frankich99/robotica_brazo_robotica/img/detalle_servo_ysd035_35kg.jpeg

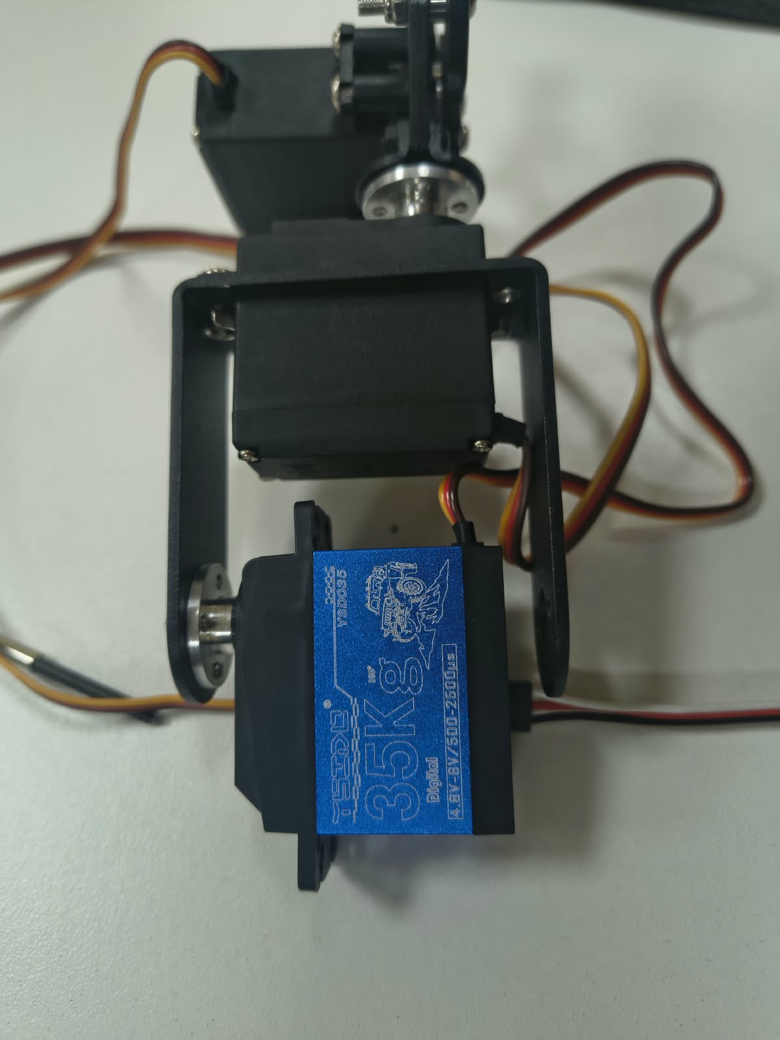
img/detalle_servo_ysd035_35kg.jpeg
