frankich99/robotica_brazo_robotica/img/esp32_cam_programador_mb.jpeg

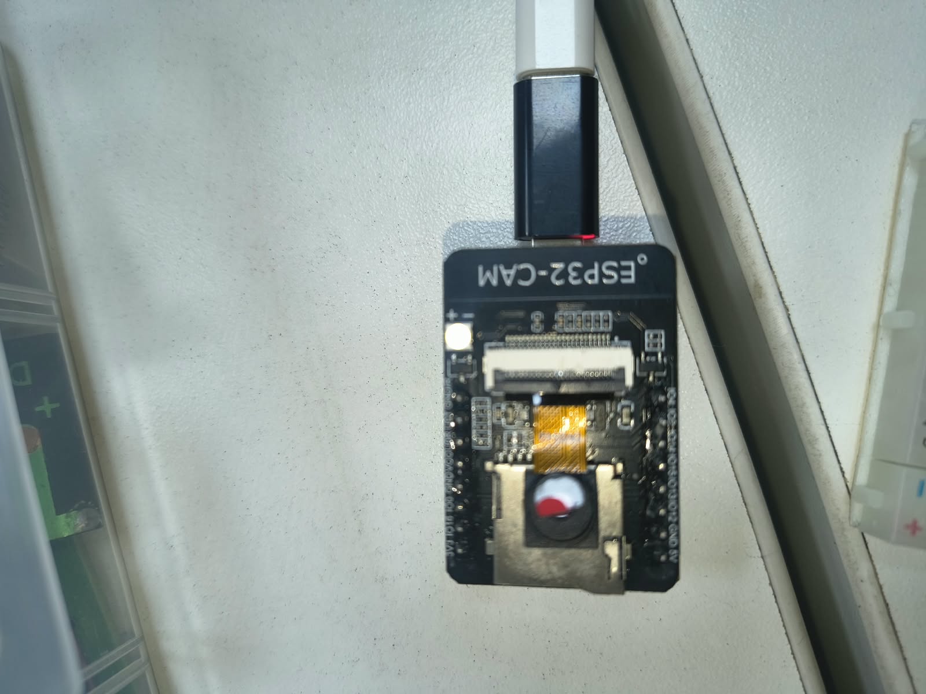
img/esp32_cam_programador_mb.jpeg
