frankich99/robotica_brazo_robotica/img/WhatsApp Image 2026-10-29 at 7.38.52 AM (4).jpeg

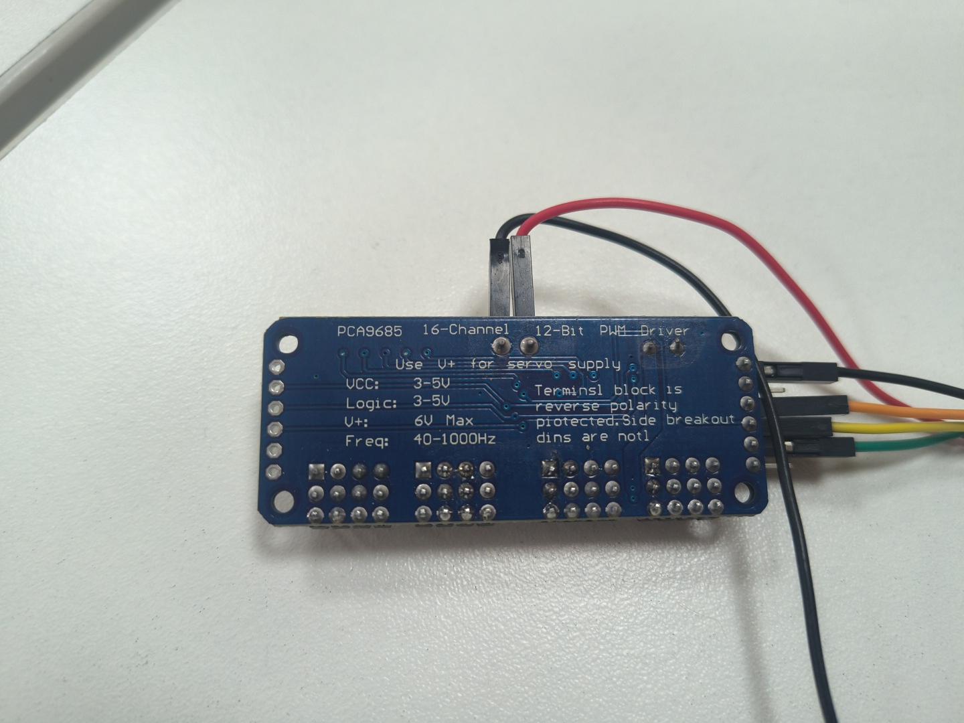
img/WhatsApp Image 2026-10-29 at 7.38.52 AM (4).jpeg
