frankich99/robotica_brazo_robotica/img/WhatsApp Image 2026-10-29 at 9.01.49 AM (1).jpeg

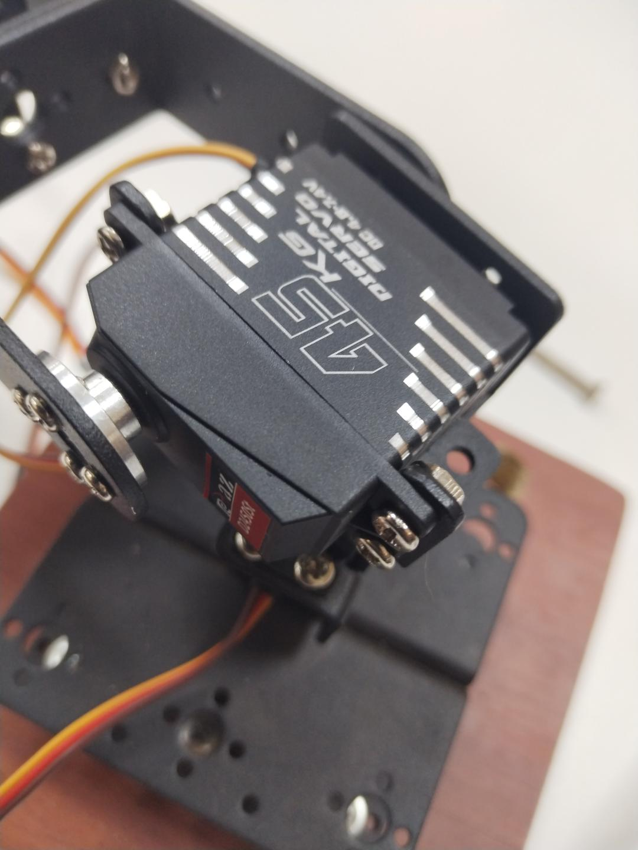
img/WhatsApp Image 2026-10-29 at 9.01.49 AM (1).jpeg
