frankich99/robotica_brazo_robotica/codigo/camara_esp32_ap_stream/camara_esp32_ap_stream.ino

#include <Arduino.h>
#include "esp_camera.h"
#include <WiFi.h>

// ===========================
// Select camera model in board_config.h
// ===========================
#include "board_config.h"

// ===========================
// MODO AP: la CAM crea su propia red
// ===========================
const char *ssid     = "FRANKI-HE";
const char *password = "123456789";   // minimo 8 caracteres

// Si prefieres modo STA (router), descomenta esta linea:
// #define USE_STA
const char *sta_ssid = "ROBOTICA_ROUTER";
const char *sta_pass = "123456789";

void startCameraServer();
void setupLedFlash();

void setup() {
  Serial.begin(115200);
  Serial.setDebugOutput(true);
  Serial.println();

  camera_config_t config;
  config.ledc_channel = LEDC_CHANNEL_0;
  config.ledc_timer = LEDC_TIMER_0;
  config.pin_d0 = Y2_GPIO_NUM;
  config.pin_d1 = Y3_GPIO_NUM;
  config.pin_d2 = Y4_GPIO_NUM;
  config.pin_d3 = Y5_GPIO_NUM;
  config.pin_d4 = Y6_GPIO_NUM;
  config.pin_d5 = Y7_GPIO_NUM;
  config.pin_d6 = Y8_GPIO_NUM;
  config.pin_d7 = Y9_GPIO_NUM;
  config.pin_xclk = XCLK_GPIO_NUM;
  config.pin_pclk = PCLK_GPIO_NUM;
  config.pin_vsync = VSYNC_GPIO_NUM;
  config.pin_href = HREF_GPIO_NUM;
  config.pin_sccb_sda = SIOD_GPIO_NUM;
  config.pin_sccb_scl = SIOC_GPIO_NUM;
  config.pin_pwdn = PWDN_GPIO_NUM;
  config.pin_reset = RESET_GPIO_NUM;
  config.xclk_freq_hz = 20000000;
  config.frame_size = FRAMESIZE_UXGA;
  config.pixel_format = PIXFORMAT_JPEG;
  config.grab_mode = CAMERA_GRAB_WHEN_EMPTY;
  config.fb_location = CAMERA_FB_IN_PSRAM;
  config.jpeg_quality = 12;
  config.fb_count = 1;

  if (config.pixel_format == PIXFORMAT_JPEG) {
    if (psramFound()) {
      config.jpeg_quality = 10;
      config.fb_count = 2;
      config.grab_mode = CAMERA_GRAB_LATEST;
    } else {
      config.frame_size = FRAMESIZE_SVGA;
      config.fb_location = CAMERA_FB_IN_DRAM;
    }
  }

#if defined(CAMERA_MODEL_ESP_EYE)
  pinMode(13, INPUT_PULLUP);
  pinMode(14, INPUT_PULLUP);
#endif

  esp_err_t err = esp_camera_init(&config);
  if (err != ESP_OK) {
    Serial.printf("Camera init failed with error 0x%x\n", err);
    return;
  }
  Serial.println("Camara inicializada correctamente");

  sensor_t *s = esp_camera_sensor_get();
  if (s->id.PID == OV3660_PID) {
    s->set_vflip(s, 1);
    s->set_brightness(s, 1);
    s->set_saturation(s, -2);
  }
  if (config.pixel_format == PIXFORMAT_JPEG) {
    s->set_framesize(s, FRAMESIZE_QVGA);
  }

#if defined(CAMERA_MODEL_M5STACK_WIDE) || defined(CAMERA_MODEL_M5STACK_ESP32CAM)
  s->set_vflip(s, 1);
  s->set_hmirror(s, 1);
#endif
#if defined(CAMERA_MODEL_ESP32S3_EYE)
  s->set_vflip(s, 1);
#endif
#if defined(LED_GPIO_NUM)
  setupLedFlash();
#endif

  // ======================= WiFi =======================
#ifdef USE_STA
  // ---- Modo cliente: se conecta a un router ----
  WiFi.mode(WIFI_STA);
  WiFi.begin(sta_ssid, sta_pass);
  WiFi.setSleep(false);

  Serial.print("WiFi connecting");
  unsigned long t0 = millis();
  while (WiFi.status() != WL_CONNECTED && millis() - t0 < 20000) {
    delay(500);
    Serial.print(".");
  }
  Serial.println();

  if (WiFi.status() == WL_CONNECTED) {
    Serial.println("WiFi connected");
    Serial.print("IP: ");
    Serial.println(WiFi.localIP());
  } else {
    Serial.println("No se pudo conectar al router. Reiniciando...");
    delay(2000);
    ESP.restart();
  }
#else
  // ---- Modo AP: crea su propia red (RECOMENDADO) ----
  WiFi.mode(WIFI_AP);
  WiFi.setSleep(false);

  if (!WiFi.softAP(ssid, password)) {
    Serial.println("ERROR: no se pudo crear el punto de acceso");
    return;
  }

  Serial.println("Punto de acceso ACTIVO");
  Serial.print("SSID: ");
  Serial.println(ssid);
  Serial.print("Clave: ");
  Serial.println(password);
  Serial.print("IP:   ");
  Serial.println(WiFi.softAPIP());
#endif
  // ====================================================

  startCameraServer();

#ifdef USE_STA
  Serial.print("Camera Ready! Use 'http://");
  Serial.print(WiFi.localIP());
  Serial.println("' to connect");
#else
  Serial.print("Camera Ready! Use 'http://");
  Serial.print(WiFi.softAPIP());
  Serial.println("/stream' to connect");
#endif
}

void loop() {
  delay(10000);
}
