frankich99/robotica_brazo_robotica/codigo/prueba_camara_esp32/test_camera_stream.ino

#include "esp_camera.h"
#include <WiFi.h>
#include "esp_timer.h"
#include "img_converters.h"
#include "Arduino.h"
#include "soc/soc.h"
#include "soc/rtc_cntl_reg.h"
#include "esp_http_server.h"

// =========================================================================
// DEFINICIÓN DE PINES - MODELO AI-THINKER ESP32-CAM
// =========================================================================
#define PWDN_GPIO_NUM     32
#define RESET_GPIO_NUM    -1
#define XCLK_GPIO_NUM      0
#define SIOD_GPIO_NUM     26
#define SIOC_GPIO_NUM     27
#define Y9_GPIO_NUM       35
#define Y8_GPIO_NUM       34
#define Y7_GPIO_NUM       39
#define Y6_GPIO_NUM       36
#define Y5_GPIO_NUM       21
#define Y4_GPIO_NUM       19
#define Y3_GPIO_NUM       18
#define Y2_GPIO_NUM        5
#define VSYNC_GPIO_NUM    25
#define HREF_GPIO_NUM     23
#define PCLK_GPIO_NUM     22

// Credenciales para modo Punto de Acceso (SoftAP)
const char* AP_SSID = "Brazo-CAM-Stream";
const char* AP_PASS = "Robotica1234";

#define PART_BOUNDARY "123456789000000000000987654321"
static const char* _STREAM_CONTENT_TYPE = "multipart/x-mixed-replace;boundary=" PART_BOUNDARY;
static const char* _STREAM_BOUNDARY = "\r\n--" PART_BOUNDARY "\r\n";
static const char* _STREAM_PART = "Content-Type: image/jpeg\r\nContent-Length: %u\r\n\r\n";

httpd_handle_t stream_httpd = NULL;

static esp_err_t stream_handler(httpd_req_t *req) {
  camera_fb_t * fb = NULL;
  esp_err_t res = ESP_OK;
  size_t _jpg_buf_len = 0;
  uint8_t * _jpg_buf = NULL;
  char * part_buf[64];

  res = httpd_resp_set_type(req, _STREAM_CONTENT_TYPE);
  if (res != ESP_OK) return res;

  while (true) {
    fb = esp_camera_fb_get();
    if (!fb) {
      Serial.println("Error: fallo al capturar frame de camara OV2640");
      res = ESP_FAIL;
    } else {
      _jpg_buf_len = fb->len;
      _jpg_buf = fb->buf;
    }

    if (res == ESP_OK) {
      size_t hlen = snprintf((char *)part_buf, 64, _STREAM_PART, _jpg_buf_len);
      res = httpd_resp_send_chunk(req, (const char *)part_buf, hlen);
    }
    if (res == ESP_OK) {
      res = httpd_resp_send_chunk(req, (const char *)_jpg_buf, _jpg_buf_len);
    }
    if (res == ESP_OK) {
      res = httpd_resp_send_chunk(req, _STREAM_BOUNDARY, strlen(_STREAM_BOUNDARY));
    }
    if (fb) {
      esp_camera_fb_return(fb);
      fb = NULL;
      _jpg_buf = NULL;
    } else if (res != ESP_OK) {
      break;
    }
  }
  return res;
}

void startCameraServer() {
  httpd_config_t config = HTTPD_DEFAULT_CONFIG();
  config.server_port = 81; // Puerto dedicado al stream de video

  httpd_uri_t stream_uri = {
    .uri       = "/stream",
    .method    = HTTP_GET,
    .handler   = stream_handler,
    .user_ctx  = NULL
  };

  if (httpd_start(&stream_httpd, &config) == ESP_OK) {
    httpd_register_uri_handler(stream_httpd, &stream_uri);
    Serial.println("Servidor de video MJPEG iniciado en puerto 81");
  }
}

void setup() {
  WRITE_PERI_REG(RTC_CNTL_BROWN_OUT_REG, 0); // Desactivar detector de brownout para picos de Wi-Fi

  Serial.begin(115200);
  Serial.setDebugOutput(true);
  Serial.println("\n--- INICIALIZANDO TEST DE CAMARA ESP32-CAM ---");

  camera_config_t config;
  config.ledc_channel = LEDC_CHANNEL_0;
  config.ledc_timer = LEDC_TIMER_0;
  config.pin_d0 = Y2_GPIO_NUM;
  config.pin_d1 = Y3_GPIO_NUM;
  config.pin_d2 = Y4_GPIO_NUM;
  config.pin_d3 = Y5_GPIO_NUM;
  config.pin_d4 = Y6_GPIO_NUM;
  config.pin_d5 = Y7_GPIO_NUM;
  config.pin_d6 = Y8_GPIO_NUM;
  config.pin_d7 = Y9_GPIO_NUM;
  config.pin_xclk = XCLK_GPIO_NUM;
  config.pin_pclk = PCLK_GPIO_NUM;
  config.pin_vsync = VSYNC_GPIO_NUM;
  config.pin_href = HREF_GPIO_NUM;
  config.pin_sscb_sda = SIOD_GPIO_NUM;
  config.pin_sscb_scl = SIOC_GPIO_NUM;
  config.pin_pwdn = PWDN_GPIO_NUM;
  config.pin_reset = RESET_GPIO_NUM;
  config.xclk_freq_hz = 20000000;
  config.pixel_format = PIXFORMAT_JPEG;
  
  // Si posee PSRAM (memoria externa), habilitar mayor resolucion
  if (psramFound()) {
    config.frame_size = FRAMESIZE_VGA; // 640x480
    config.jpeg_quality = 12;
    config.fb_count = 2;
    Serial.println("PSRAM detectada: modo VGA habilitado");
  } else {
    config.frame_size = FRAMESIZE_QVGA; // 320x240
    config.jpeg_quality = 14;
    config.fb_count = 1;
    Serial.println("PSRAM no disponible: modo QVGA");
  }

  // Inicializar sensor de camara
  esp_err_t err = esp_camera_init(&config);
  if (err != ESP_OK) {
    Serial.printf("Error fatal: fallo de inicializacion de camara 0x%x\n", err);
    return;
  }
  Serial.println("Camara OV2640 inicializada correctamente");

  // Configurar punto de acceso Wi-Fi
  WiFi.softAP(AP_SSID, AP_PASS);
  IPAddress IP = WiFi.softAPIP();
  Serial.print("Punto de acceso creado: ");
  Serial.println(AP_SSID);
  Serial.print("URL de transmision en vivo: http://");
  Serial.print(IP);
  Serial.println(":81/stream");

  startCameraServer();
}

void loop() {
  delay(1000);
}
