frankich99/robotica_brazo_robotica/(commit log)

2026-10-30 feat: estructura inicial de brazo robotico 6 GDL - firmware, diagramas, latex e imagenes
2026-11-01 feat: integracion de modulos web camera stream, ap streaming y actualizacion de informe
    [partitions.csv]
2026-11-09 Insert new evidence section in main.tex
    Added new evidence section with November updates.
2026-11-09 Actualizar informe PDF con evidencias de montaje, conexiones y calibración
